DavidJRobertson/wordclock/hardware/outputdriver.sch

## KiCad design hardware/outputdriver.sch (2012-07-17)

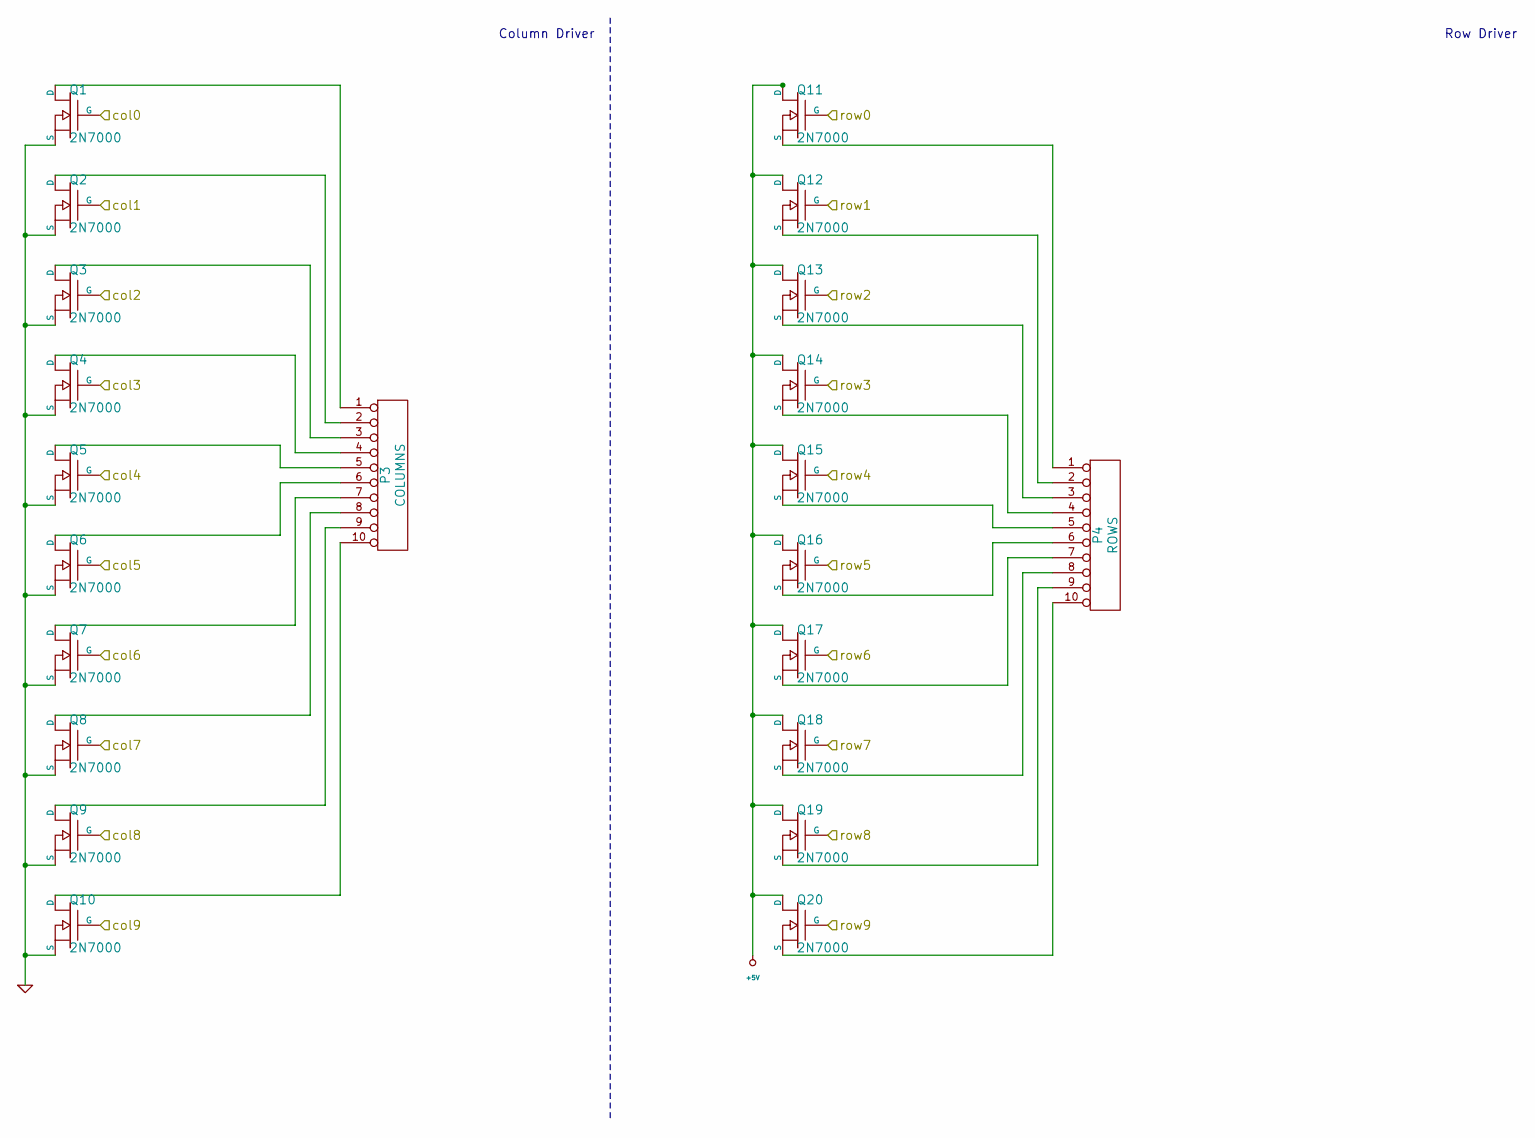
[picture p1: schematic outputdriver.sch]

Parts:
P3: COLUMNS; SIL-10
P4: ROWS; SIL-10
Q1, Q2, Q3, Q4, Q5, Q6, Q7, Q8, Q9, Q10, Q11, Q12, Q13, Q14, Q15, Q16, Q17, Q18, Q19, Q20: 2N7000; TO92

Connections:
+5V: Q11.3 (D), Q12.3 (D), Q13.3 (D), Q14.3 (D), Q15.3 (D), Q16.3 (D), Q17.3 (D), Q18.3 (D), Q19.3 (D), Q20.3 (D)
GND: Q1.1 (S), Q2.1 (S), Q3.1 (S), Q4.1 (S), Q5.1 (S), Q6.1 (S), Q7.1 (S), Q8.1 (S), Q9.1 (S), Q10.1 (S)
unnamed: P3.1, Q1.3 (D)
unnamed: P3.2, Q2.3 (D)
unnamed: P3.3, Q3.3 (D)
unnamed: P3.4, Q4.3 (D)
unnamed: P3.5, Q5.3 (D)
unnamed: P3.6, Q6.3 (D)
unnamed: P3.7, Q7.3 (D)
unnamed: P3.8, Q8.3 (D)
unnamed: P3.9, Q9.3 (D)
unnamed: P3.10, Q10.3 (D)
unnamed: P4.1, Q11.1 (S)
unnamed: P4.2, Q12.1 (S)
unnamed: P4.3, Q13.1 (S)
unnamed: P4.4, Q14.1 (S)
unnamed: P4.5, Q15.1 (S)
unnamed: P4.6, Q16.1 (S)
unnamed: P4.7, Q17.1 (S)
unnamed: P4.8, Q18.1 (S)
unnamed: P4.9, Q19.1 (S)
unnamed: P4.10, Q20.1 (S)
col0: Q1.2 (G)
col1: Q2.2 (G)
col2: Q3.2 (G)
col3: Q4.2 (G)
col4: Q5.2 (G)
col5: Q6.2 (G)
col6: Q7.2 (G)
col7: Q8.2 (G)
col8: Q9.2 (G)
col9: Q10.2 (G)
row0: Q11.2 (G)
row1: Q12.2 (G)
row2: Q13.2 (G)
row3: Q14.2 (G)
row4: Q15.2 (G)
row5: Q16.2 (G)
row6: Q17.2 (G)
row7: Q18.2 (G)
row8: Q19.2 (G)
row9: Q20.2 (G)

Notes on the sheet:
Row Driver
Column Driver
