DavidJRobertson/wordclock/hardware/wordclock.sch

## KiCad design hardware/wordclock.sch (2012-07-17)

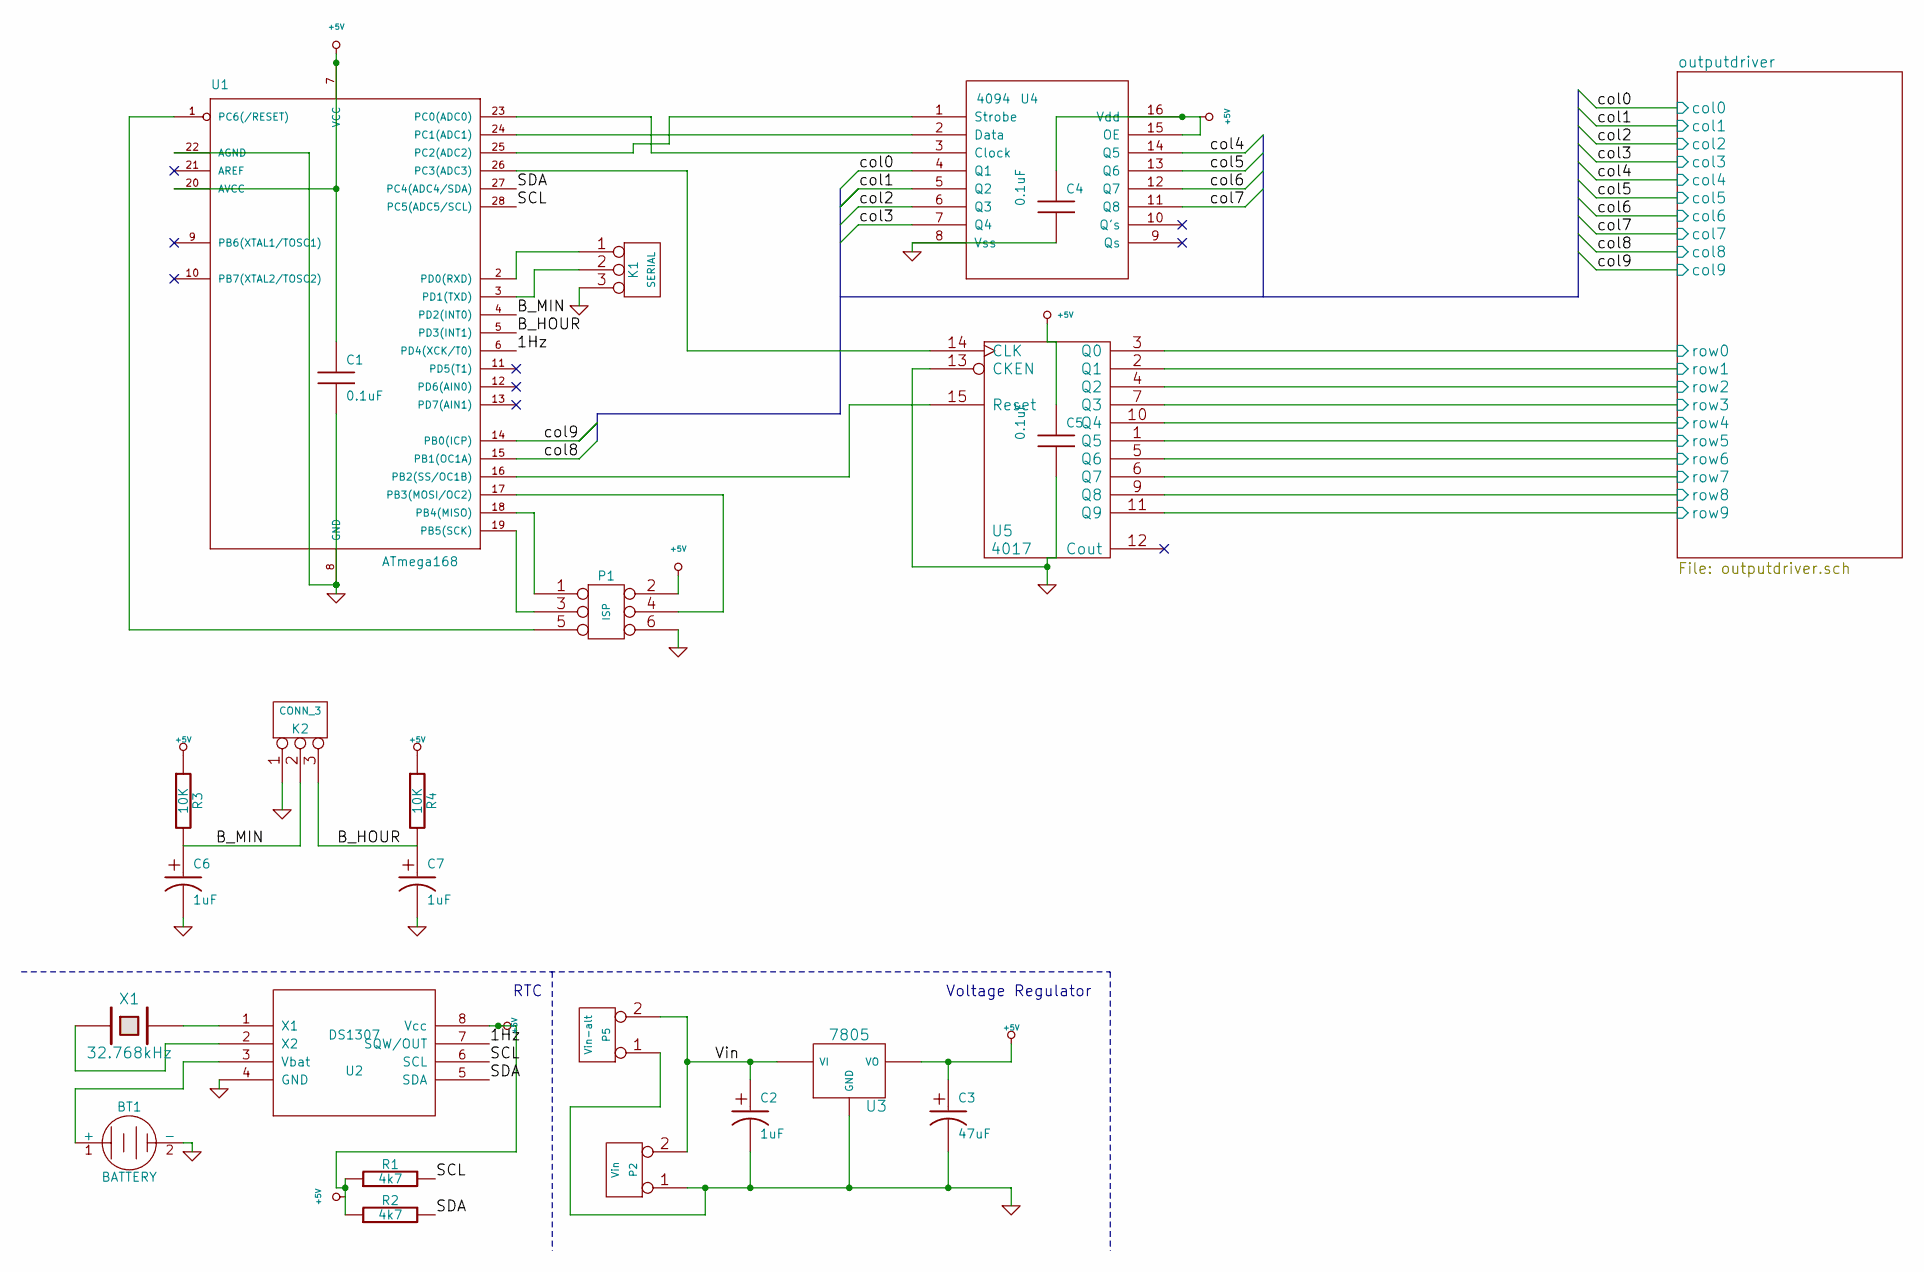
[picture p2: schematic wordclock.sch]

Parts:
BT1: BATTERY; CR2032H
C1, C4, C5: 0.1uF; C1
C2: 1uF; C1V7
C3: 47uF; C1V7
C6, C7: 1uF
K1: SERIAL; PIN_ARRAY_3X1
K2: CONN_3
P1: ISP; pin_array_3x2
P2: Vin; SIL-2
P5: Vin-alt; SIL-2
R1, R2: 4k7
R3, R4: 10K
U1: ATmega168; DIP-28__300
U2: DS1307; DIP-8__300
U3: 7805; TO220
U4: 4094; DIP-16__300
U5: 4017; DIP-16__300
X1: 32.768kHz; r26-crystal

Connections:
1Hz: U1.6 (PD4(XCK/T0)), U2.7 (SQW/OUT)
+5V: C1.1, C3.1, C4.1, C5.1, P1.2, R1.1, R2.1, R3.1, R4.1, U1.7 (VCC), U1.20 (AVCC), U2.8 (Vcc), U3.3 (VO), U4.15 (OE), U4.16 (Vdd), U5.16 (VDD)
B_HOUR: C7.1, K2.3, R4.2, U1.5 (PD3(INT1))
B_MIN: C6.1, K2.2 (PM), R3.2, U1.4 (PD2(INT0))
GND: BT1.2 (-), C1.2, C2.2, C3.2, C4.2, C5.2, C6.2, C7.2, K1.3, K2.1, P1.6, P2.1, P5.1, U1.8 (GND), U1.22 (AGND), U2.4 (GND), U3.2 (GND), U4.8 (Vss), U5.8 (VSS), U5.13 (CKEN)
unnamed: BT1.1 (+), U2.3 (Vbat)
unnamed: K1.1, U1.2 (PD0(RXD))
unnamed: K1.2 (PM), U1.3 (PD1(TXD))
unnamed: P1.1, U1.18 (PB4(MISO))
unnamed: P1.3, U1.19 (PB5(SCK))
unnamed: P1.4, U1.17 (PB3(MOSI/OC2))
unnamed: P1.5, U1.1 (PC6(/RESET))
unnamed: U1.16 (PB2(SS/OC1B)), U5.15 (Reset)
unnamed: U1.23 (PC0(ADC0)), U4.3 (Clock)
unnamed: U1.24 (PC1(ADC1)), U4.2 (Data)
unnamed: U1.25 (PC2(ADC2)), U4.1 (Strobe)
unnamed: U1.26 (PC3(ADC3)), U5.14 (CLK)
unnamed: U2.1 (X1), X1.2
unnamed: U2.2 (X2), X1.1
SCL: R1.2, U1.28 (PC5(ADC5/SCL)), U2.6 (SCL)
SDA: R2.2, U1.27 (PC4(ADC4/SDA)), U2.5 (SDA)
Vin: C2.1, P2.2 (PM), P5.2 (PM), U3.1 (VI)
col0: U4.4 (Q1)
col1: U4.5 (Q2)
col2: U4.6 (Q3)
col3: U4.7 (Q4)
col4: U4.14 (Q5)
col5: U4.13 (Q6)
col6: U4.12 (Q7)
col7: U4.11 (Q8)
col8: U1.15 (PB1(OC1A))
col9: U1.14 (PB0(ICP))
row0: U5.3 (Q0)
row1: U5.2 (Q1)
row2: U5.4 (Q2)
row3: U5.7 (Q3)
row4: U5.10 (Q4)
row5: U5.1 (Q5)
row6: U5.5 (Q6)
row7: U5.6 (Q7)
row8: U5.9 (Q8)
row9: U5.11 (Q9)

Notes on the sheet:
Voltage Regulator
RTC
