DavidJRobertson/wordclock/(commit log)

2012-05-07 Set up timer/counter0 to accept 1Hz signal from RTC, and every 60 cycles fire an interrupt to increment the time and generate new screen data.
2012-05-08 Slight improvement on LED array row/column update synchronization issues.
    [main.c]
2012-05-08 Whoops, typo in setting counter clock source and forgot to globally enable interrupts.
2012-05-08 Fixed bug where, once displayed, "O'CLOCK" would never deactivate. Fixed 0ff-by-one error for counter compare value.
    [main.c]
2012-05-08 Fixed typo in comment.
    [main.c]
2012-05-08 Fixed bug where "TO" would stay lit while displaying "O'CLOCK".
    [main.c]
2012-05-10 Fixed bug incorrectly initializing shift register data line.
    [main.c]
2012-05-10 Added KiCAD schematic
    [outputdriver.sch, wordclock.sch]
2012-05-10 Fixed some symbol problems causing ERC warnings. Generated netlist.
    [outputdriver.sch, wordclock.sch]
2012-05-11 Added I2C interface code + ds1307 low-level code + set up 1Hz output.
2012-05-16 Tidied up a bit, I2C interface to RTC not yet working.
    [wordclock.csv]
2012-06-19 Beginning of PCB layout.
    [$savepcb.brd, outputdriver.sch, wordclock.brd, wordclock.sch]
2012-06-19 REV. A PCB nearly complete.
    [$savepcb.brd, outputdriver.sch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]
2012-06-19 Updated gerbers
    [wordclock-Back.gbl, wordclock-Front.gtl, wordclock-Mask_Back.gbs, wordclock-Mask_Front.gts, wordclock-PCB_Edges.gbr, wordclock-SilkS_Back.gbo, wordclock-SilkS_Front.gto, wordclock.drl]
2012-06-19 Fixed measurements.
    [wordclock.brd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]
2012-06-19 Added ground fill around 32.768kHz crystal on both layers of the PCB.
    [wordclock.brd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]
2012-06-20 Mostly done PCB.
    [$savepcb.brd, outputdriver.sch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]
2012-06-23 Moved gerbers to hardware/gerbers/ directory and added to gitignore.
    [$savepcb.brd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]
2012-07-09 Added code for minute and hour increment buttons
2012-07-09 Fixed OBOE where the minute was 61 seconds long... Oops
    [main.c]
2012-07-09 Fixed bug which would not display TWELVE at times between 23:35 and 23:59.
    [main.c]
2012-07-12 Added clock face files.
    [CLOCKFACE.ods]
2012-07-12 Added time set buttons to schematic.
    [$savepcb.brd, outputdriver.sch, wordclock.brd, wordclock.sch]
2012-07-12 Added clock face files updated for Katie.
    [CLOCKFACE.ods]
2012-07-17 Finished PCB design, REV. A.
    [$savepcb.brd, outputdriver.sch, wordclock.brd, wordclock.sch]
2012-09-18 Code styles...
    [CLOCKFACE.ods]
